guolic1/LumaFlow/shell/LumaFlowShell.FCStd

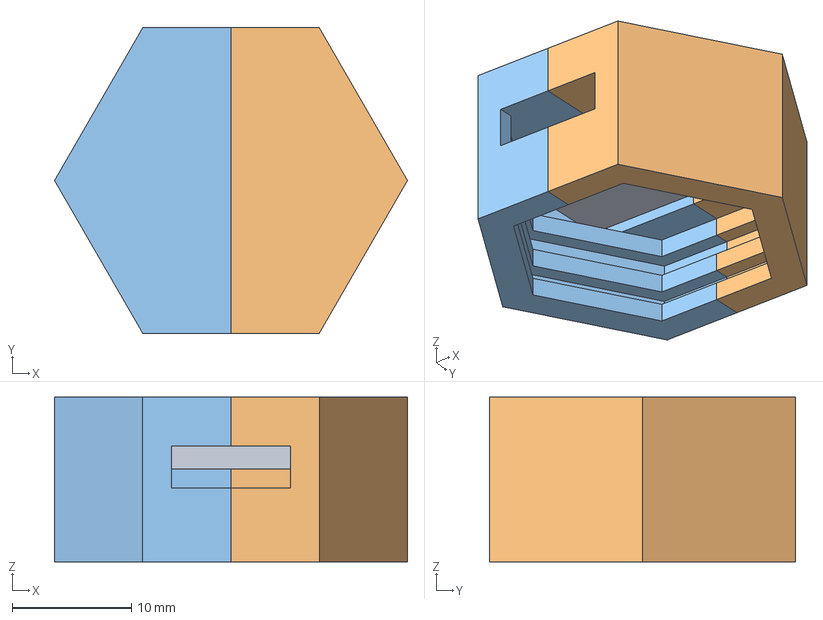
[picture p1: CAD file, 2026-10-01]
shell/LumaFlowShell.FCStd
29.6 x 25.6 x 13.8 mm
Battary
Left
