guolic1/LumaFlow/circuit/LumaFlow.kicad_pcb

## KiCad design circuit/LumaFlow.kicad_pcb (2026-09-30)

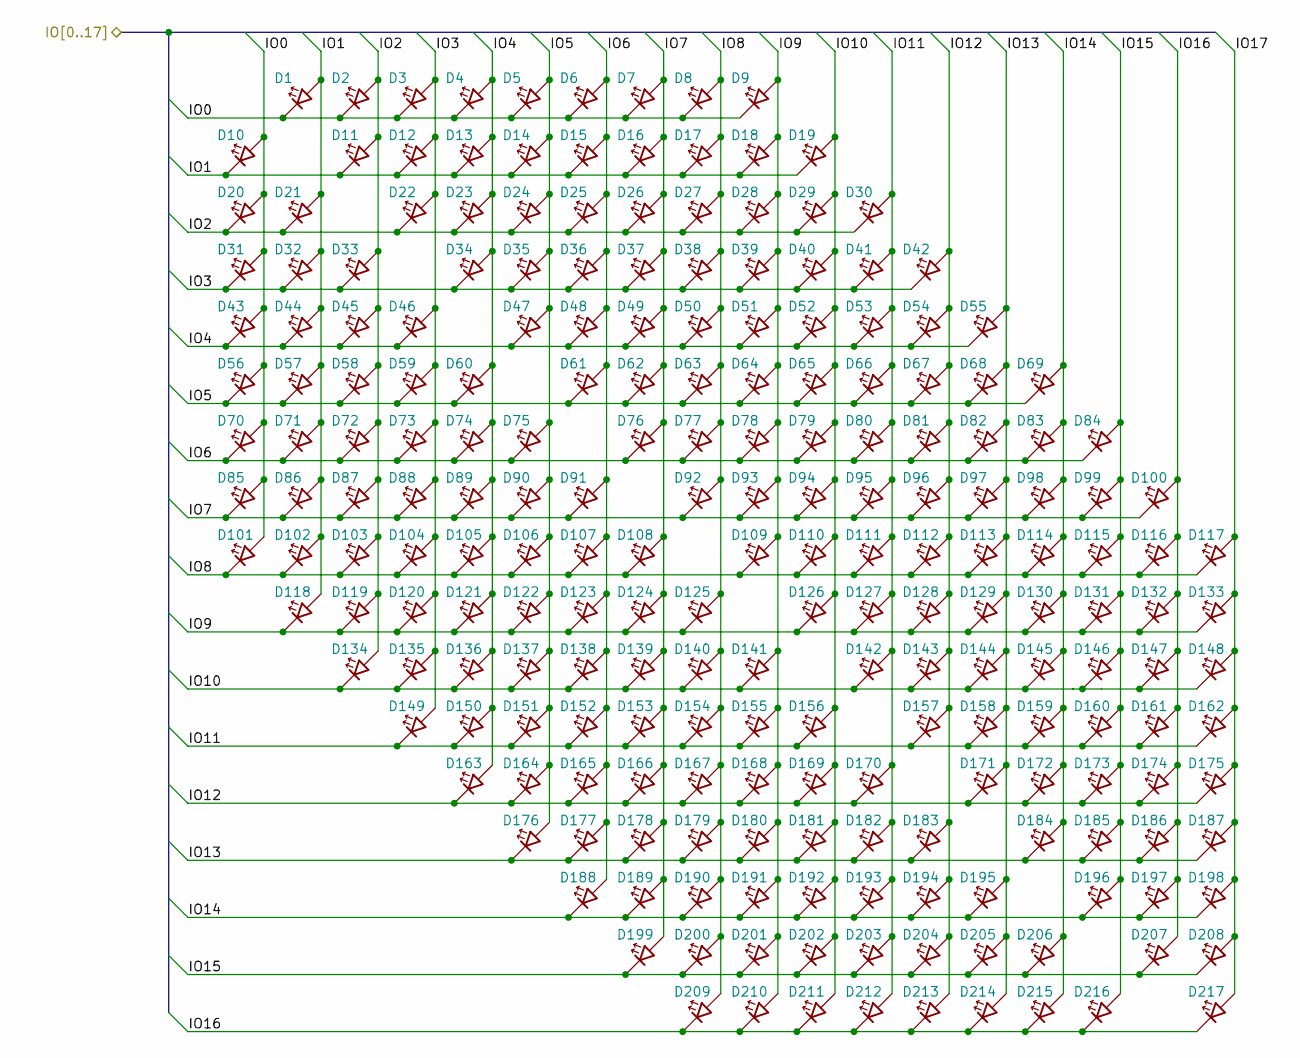
[picture p2: schematic LED_Matrix.kicad_sch]

Parts:
D1, D2, D3, D4, D5, D6, D7, D8, D9, D10, D11, D12, D13, D14, D15, D16, D17, D18, D19, D20, D21, D22, D23, D24, D25, D26, D27, D28, D29, D30, D31, D32, D33, D34, D35, D36, D37, D38, D39, D40, D41, D42, D43, D44, D45, D46, D47, D48, D49, D50, D51, D52, D53, D54, D55, D56, D57, D58, D59, D60, D61, D62, D63, D64, D65, D66, D67, D68, D69, D70, D71, D72, D73, D74, D75, D76, D77, D78, D79, D80, D81, D82, D83, D84, D85, D86, D87, D88, D89, D90, D91, D92, D93, D94, D95, D96, D97, D98, D99, D100, D101, D102, D103, D104, D105, D106, D107, D108, D109, D110, D111, D112, D113, D114, D115, D116, D117, D118, D119, D120, D121, D122, D123, D124, D125, D126, D127, D128, D129, D130, D131, D132, D133, D134, D135, D136, D137, D138, D139, D140, D141, D142, D143, D144, D145, D146, D147, D148, D149, D150, D151, D152, D153, D154, D155, D156, D157, D158, D159, D160, D161, D162, D163, D164, D165, D166, D167, D168, D169, D170, D171, D172, D173, D174, D175, D176, D177, D178, D179, D180, D181, D182, D183, D184, D185, D186, D187, D188, D189, D190, D191, D192, D193, D194, D195, D196, D197, D198, D199, D200, D201, D202, D203, D204, D205, D206, D207, D208, D209, D210, D211, D212, D213, D214, D215, D216, D217: LED; LED_0402_1005Metric

Connections:
/LED Matrix/IO0: D1.1 (K), D2.1 (K), D3.1 (K), D4.1 (K), D5.1 (K), D6.1 (K), D7.1 (K), D8.1 (K), D9.1 (K), D10.2 (A), D20.2 (A), D31.2 (A), D43.2 (A), D56.2 (A), D70.2 (A), D85.2 (A), D101.2 (A); also elsewhere on the board
/LED Matrix/IO1: D1.2 (A), D10.1 (K), D11.1 (K), D12.1 (K), D13.1 (K), D14.1 (K), D15.1 (K), D16.1 (K), D17.1 (K), D18.1 (K), D19.1 (K), D21.2 (A), D32.2 (A), D44.2 (A), D57.2 (A), D71.2 (A), D86.2 (A), D102.2 (A), D118.2 (A); also elsewhere on the board
/LED Matrix/IO2: D2.2 (A), D11.2 (A), D20.1 (K), D21.1 (K), D22.1 (K), D23.1 (K), D24.1 (K), D25.1 (K), D26.1 (K), D27.1 (K), D28.1 (K), D29.1 (K), D30.1 (K), D33.2 (A), D45.2 (A), D58.2 (A), D72.2 (A), D87.2 (A), D103.2 (A), D119.2 (A), D134.2 (A); also elsewhere on the board
/LED Matrix/IO3: D3.2 (A), D12.2 (A), D22.2 (A), D31.1 (K), D32.1 (K), D33.1 (K), D34.1 (K), D35.1 (K), D36.1 (K), D37.1 (K), D38.1 (K), D39.1 (K), D40.1 (K), D41.1 (K), D42.1 (K), D46.2 (A), D59.2 (A), D73.2 (A), D88.2 (A), D104.2 (A), D120.2 (A), D135.2 (A), D149.2 (A); also elsewhere on the board
/LED Matrix/IO4: D4.2 (A), D13.2 (A), D23.2 (A), D34.2 (A), D43.1 (K), D44.1 (K), D45.1 (K), D46.1 (K), D47.1 (K), D48.1 (K), D49.1 (K), D50.1 (K), D51.1 (K), D52.1 (K), D53.1 (K), D54.1 (K), D55.1 (K), D60.2 (A), D74.2 (A), D89.2 (A), D105.2 (A), D121.2 (A), D136.2 (A), D150.2 (A), D163.2 (A); also elsewhere on the board
/LED Matrix/IO5: D5.2 (A), D14.2 (A), D24.2 (A), D35.2 (A), D47.2 (A), D56.1 (K), D57.1 (K), D58.1 (K), D59.1 (K), D60.1 (K), D61.1 (K), D62.1 (K), D63.1 (K), D64.1 (K), D65.1 (K), D66.1 (K), D67.1 (K), D68.1 (K), D69.1 (K), D75.2 (A), D90.2 (A), D106.2 (A), D122.2 (A), D137.2 (A), D151.2 (A), D164.2 (A), D176.2 (A); also elsewhere on the board
/LED Matrix/IO6: D6.2 (A), D15.2 (A), D25.2 (A), D36.2 (A), D48.2 (A), D61.2 (A), D70.1 (K), D71.1 (K), D72.1 (K), D73.1 (K), D74.1 (K), D75.1 (K), D76.1 (K), D77.1 (K), D78.1 (K), D79.1 (K), D80.1 (K), D81.1 (K), D82.1 (K), D83.1 (K), D84.1 (K), D91.2 (A), D107.2 (A), D123.2 (A), D138.2 (A), D152.2 (A), D165.2 (A), D177.2 (A), D188.2 (A); also elsewhere on the board
/LED Matrix/IO7: D7.2 (A), D16.2 (A), D26.2 (A), D37.2 (A), D49.2 (A), D62.2 (A), D76.2 (A), D85.1 (K), D86.1 (K), D87.1 (K), D88.1 (K), D89.1 (K), D90.1 (K), D91.1 (K), D92.1 (K), D93.1 (K), D94.1 (K), D95.1 (K), D96.1 (K), D97.1 (K), D98.1 (K), D99.1 (K), D100.1 (K), D108.2 (A), D124.2 (A), D139.2 (A), D153.2 (A), D166.2 (A), D178.2 (A), D189.2 (A), D199.2 (A); also elsewhere on the board
/LED Matrix/IO8: D8.2 (A), D17.2 (A), D27.2 (A), D38.2 (A), D50.2 (A), D63.2 (A), D77.2 (A), D92.2 (A), D101.1 (K), D102.1 (K), D103.1 (K), D104.1 (K), D105.1 (K), D106.1 (K), D107.1 (K), D108.1 (K), D109.1 (K), D110.1 (K), D111.1 (K), D112.1 (K), D113.1 (K), D114.1 (K), D115.1 (K), D116.1 (K), D117.1 (K), D125.2 (A), D140.2 (A), D154.2 (A), D167.2 (A), D179.2 (A), D190.2 (A), D200.2 (A), D209.2 (A); also elsewhere on the board
/LED Matrix/IO9: D9.2 (A), D18.2 (A), D28.2 (A), D39.2 (A), D51.2 (A), D64.2 (A), D78.2 (A), D93.2 (A), D109.2 (A), D118.1 (K), D119.1 (K), D120.1 (K), D121.1 (K), D122.1 (K), D123.1 (K), D124.1 (K), D125.1 (K), D126.1 (K), D127.1 (K), D128.1 (K), D129.1 (K), D130.1 (K), D131.1 (K), D132.1 (K), D133.1 (K), D141.2 (A), D155.2 (A), D168.2 (A), D180.2 (A), D191.2 (A), D201.2 (A), D210.2 (A); also elsewhere on the board
/LED Matrix/IO10: D19.2 (A), D29.2 (A), D40.2 (A), D52.2 (A), D65.2 (A), D79.2 (A), D94.2 (A), D110.2 (A), D126.2 (A), D134.1 (K), D135.1 (K), D136.1 (K), D137.1 (K), D138.1 (K), D139.1 (K), D140.1 (K), D141.1 (K), D142.1 (K), D143.1 (K), D144.1 (K), D145.1 (K), D146.1 (K), D147.1 (K), D148.1 (K), D156.2 (A), D169.2 (A), D181.2 (A), D192.2 (A), D202.2 (A), D211.2 (A); also elsewhere on the board
/LED Matrix/IO11: D30.2 (A), D41.2 (A), D53.2 (A), D66.2 (A), D80.2 (A), D95.2 (A), D111.2 (A), D127.2 (A), D142.2 (A), D149.1 (K), D150.1 (K), D151.1 (K), D152.1 (K), D153.1 (K), D154.1 (K), D155.1 (K), D156.1 (K), D157.1 (K), D158.1 (K), D159.1 (K), D160.1 (K), D161.1 (K), D162.1 (K), D170.2 (A), D182.2 (A), D193.2 (A), D203.2 (A), D212.2 (A); also elsewhere on the board
/LED Matrix/IO12: D42.2 (A), D54.2 (A), D67.2 (A), D81.2 (A), D96.2 (A), D112.2 (A), D128.2 (A), D143.2 (A), D157.2 (A), D163.1 (K), D164.1 (K), D165.1 (K), D166.1 (K), D167.1 (K), D168.1 (K), D169.1 (K), D170.1 (K), D171.1 (K), D172.1 (K), D173.1 (K), D174.1 (K), D175.1 (K), D183.2 (A), D194.2 (A), D204.2 (A), D213.2 (A); also elsewhere on the board
/LED Matrix/IO13: D55.2 (A), D68.2 (A), D82.2 (A), D97.2 (A), D113.2 (A), D129.2 (A), D144.2 (A), D158.2 (A), D171.2 (A), D176.1 (K), D177.1 (K), D178.1 (K), D179.1 (K), D180.1 (K), D181.1 (K), D182.1 (K), D183.1 (K), D184.1 (K), D185.1 (K), D186.1 (K), D187.1 (K), D195.2 (A), D205.2 (A), D214.2 (A); also elsewhere on the board
/LED Matrix/IO14: D69.2 (A), D83.2 (A), D98.2 (A), D114.2 (A), D130.2 (A), D145.2 (A), D159.2 (A), D172.2 (A), D184.2 (A), D188.1 (K), D189.1 (K), D190.1 (K), D191.1 (K), D192.1 (K), D193.1 (K), D194.1 (K), D195.1 (K), D196.1 (K), D197.1 (K), D198.1 (K), D206.2 (A), D215.2 (A); also elsewhere on the board
/LED Matrix/IO15: D84.2 (A), D99.2 (A), D115.2 (A), D131.2 (A), D146.2 (A), D160.2 (A), D173.2 (A), D185.2 (A), D196.2 (A), D199.1 (K), D200.1 (K), D201.1 (K), D202.1 (K), D203.1 (K), D204.1 (K), D205.1 (K), D206.1 (K), D207.1 (K), D208.1 (K), D216.2 (A); also elsewhere on the board
/LED Matrix/IO16: D100.2 (A), D116.2 (A), D132.2 (A), D147.2 (A), D161.2 (A), D174.2 (A), D186.2 (A), D197.2 (A), D207.2 (A), D209.1 (K), D210.1 (K), D211.1 (K), D212.1 (K), D213.1 (K), D214.1 (K), D215.1 (K), D216.1 (K), D217.1 (K); also elsewhere on the board
/LED Matrix/IO17: D117.2 (A), D133.2 (A), D148.2 (A), D162.2 (A), D175.2 (A), D187.2 (A), D198.2 (A), D208.2 (A), D217.2 (A); also elsewhere on the board

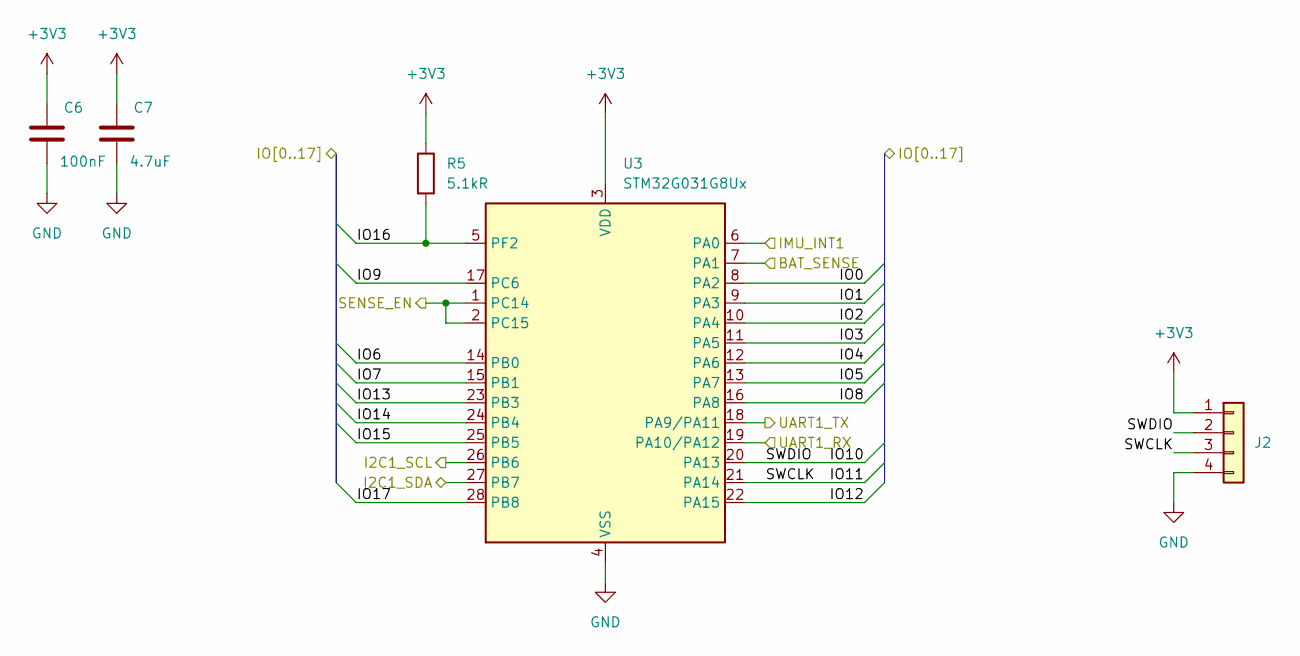
[picture p3: schematic MCU.kicad_sch]

Parts:
C6: 100nF; C_0402_1005Metric
C7: 4.7uF; C_0402_1005Metric
J2: Conn_01x04; PinSocket_1x04_P1.27mm_Vertical
R5: 5.1kR; R_0402_1005Metric
U3: STM32G031G8Ux; QFN-28_4x4mm_P0.5mm

Connections:
+3V3: C6.1, C7.1, J2.1, R5.1, U3.3 (VDD); also elsewhere on the board
/IMU/INT1: U3.6 (PA0); also elsewhere on the board
/IMU/SCL: U3.26 (PB6); also elsewhere on the board
/IMU/SDA: U3.27 (PB7); also elsewhere on the board
/LED Matrix/IO0: U3.8 (PA2); also elsewhere on the board
/LED Matrix/IO1: U3.9 (PA3); also elsewhere on the board
/LED Matrix/IO2: U3.10 (PA4); also elsewhere on the board
/LED Matrix/IO3: U3.11 (PA5); also elsewhere on the board
/LED Matrix/IO4: U3.12 (PA6); also elsewhere on the board
/LED Matrix/IO5: U3.13 (PA7); also elsewhere on the board
/LED Matrix/IO6: U3.14 (PB0); also elsewhere on the board
/LED Matrix/IO7: U3.15 (PB1); also elsewhere on the board
/LED Matrix/IO8: U3.16 (PA8); also elsewhere on the board
/LED Matrix/IO9: U3.17 (PC6); also elsewhere on the board
/LED Matrix/IO10: J2.2, U3.20 (PA13); also elsewhere on the board
/LED Matrix/IO11: J2.3, U3.21 (PA14); also elsewhere on the board
/LED Matrix/IO12: U3.22 (PA15); also elsewhere on the board
/LED Matrix/IO13: U3.23 (PB3); also elsewhere on the board
/LED Matrix/IO14: U3.24 (PB4); also elsewhere on the board
/LED Matrix/IO15: U3.25 (PB5); also elsewhere on the board
/LED Matrix/IO16: R5.2, U3.5 (PF2); also elsewhere on the board
/LED Matrix/IO17: U3.28 (PB8); also elsewhere on the board
/MCU/BAT_SENSE: U3.7 (PA1); also elsewhere on the board
/MCU/SENSE_EN: U3.1 (PC14), U3.2 (PC15); also elsewhere on the board
/MCU/UART1_RX: U3.19 (PA10/PA12); also elsewhere on the board
/MCU/UART1_TX: U3.18 (PA9/PA11); also elsewhere on the board
GND: C6.2, C7.2, J2.4, U3.4 (VSS); also elsewhere on the board

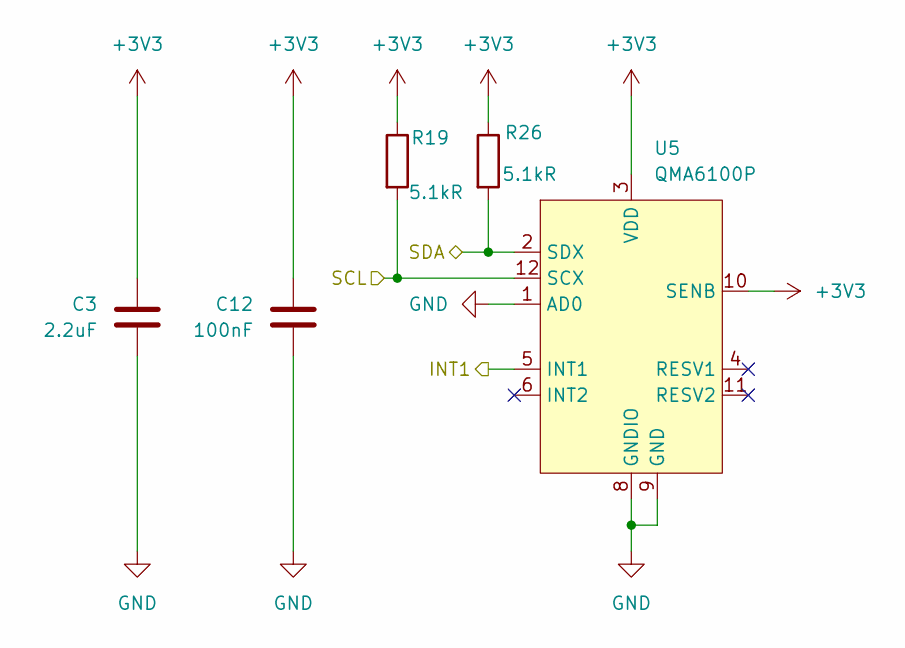
[picture p4: schematic IMU.kicad_sch]

Parts:
C3: 2.2uF; C_0402_1005Metric
C12: 100nF; C_0402_1005Metric
R19, R26: 5.1kR; R_0402_1005Metric
U5: QMA6100P; LGA-12_2x2mm_P0.5mm

Connections:
+3V3: C3.1, C12.1, R19.1, R26.1, U5.3 (VDD), U5.10 (SENB); also elsewhere on the board
/IMU/INT1: U5.5 (INT1); also elsewhere on the board
/IMU/SCL: R19.2, U5.12 (SCX); also elsewhere on the board
/IMU/SDA: R26.2, U5.2 (SDX); also elsewhere on the board
GND: C3.2, C12.2, U5.1 (AD0), U5.8 (GNDIO), U5.9 (GND); also elsewhere on the board

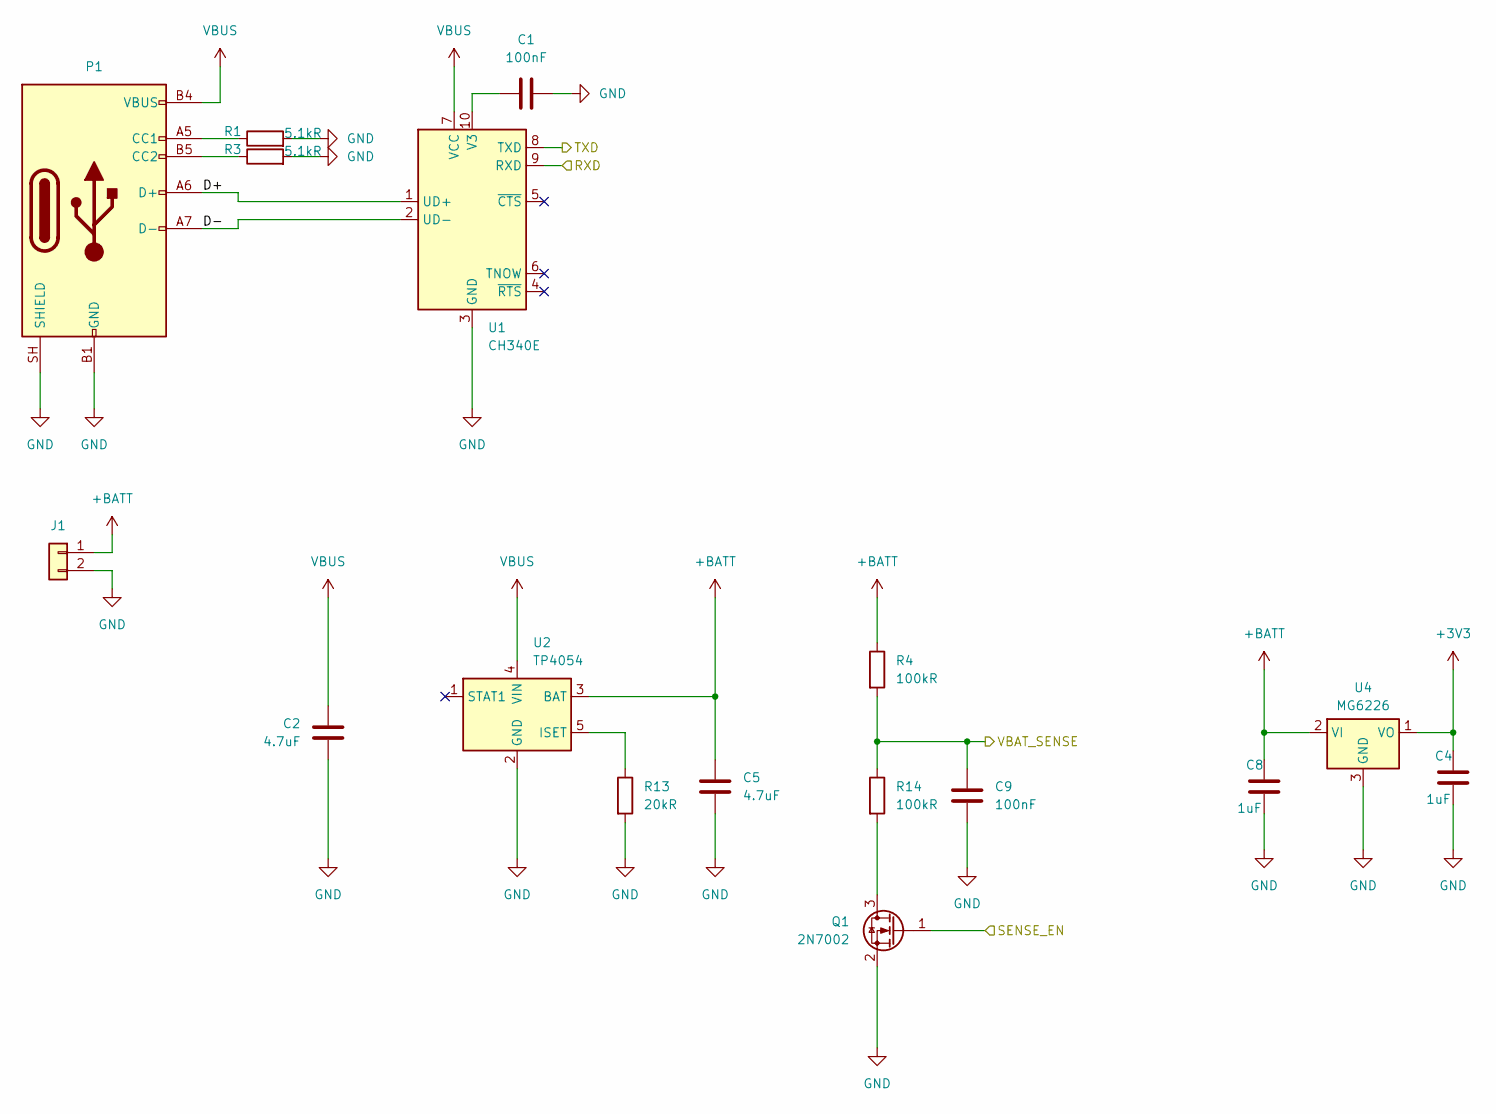
[picture p5: schematic Power.kicad_sch]

Parts:
C1, C9: 100nF; C_0402_1005Metric
C2, C5: 4.7uF; C_0402_1005Metric
C4, C8: 1uF; C_0402_1005Metric
J1: Conn_01x02
P1: USB_C_Plug_USB2.0_8Pin; USB-C-SMD_MC-402L68
Q1: 2N7002; SOT-323_SC-70
R1, R3: 5.1kR; R_0402_1005Metric
R4, R14: 100kR; R_0402_1005Metric
R13: 20kR; R_0402_1005Metric
U1: CH340E; MSOP-10_3x3mm_P0.5mm
U2: TP4054; SOT-23-5
U4: MG6226; SOT-23-3

Connections:
+3V3: C4.1, U4.1 (VO); also elsewhere on the board
+BATT: C5.1, C8.1, J1.1, R4.1, U2.3 (BAT), U4.2 (VI)
/MCU/BAT_SENSE: C9.1, R4.2, R14.1; also elsewhere on the board
/MCU/SENSE_EN: Q1.1 (G); also elsewhere on the board
/MCU/UART1_RX: U1.8 (TXD); also elsewhere on the board
/MCU/UART1_TX: U1.9 (RXD); also elsewhere on the board
/Power/D+: P1.A6 (D+), U1.1 (UD+)
/Power/D-: P1.A7 (D-), U1.2 (UD-)
GND: C1.2, C2.2, C4.2, C5.2, C8.2, C9.2, J1.2, P1.B1 (GND), P1.B12 (GND), P1.SH (SHIELD), Q1.2 (S), R1.2, R3.2, R13.2, U1.3 (GND), U2.2 (GND), U4.3 (GND); also elsewhere on the board
unnamed: P1.A5 (CC1), R1.1
unnamed: P1.B5 (CC2), R3.1
unnamed: Q1.3 (D), R14.2
unnamed: C1.1, U1.10 (V3)
unnamed: R13.1, U2.5 (ISET)
VBUS: C2.1, P1.B4 (VBUS), P1.B9 (VBUS), U1.7 (VCC), U2.4 (VIN)

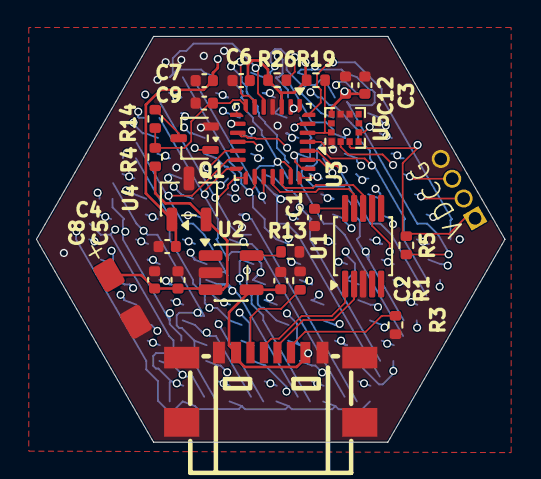
[picture p6: board LumaFlow.kicad_pcb from above]

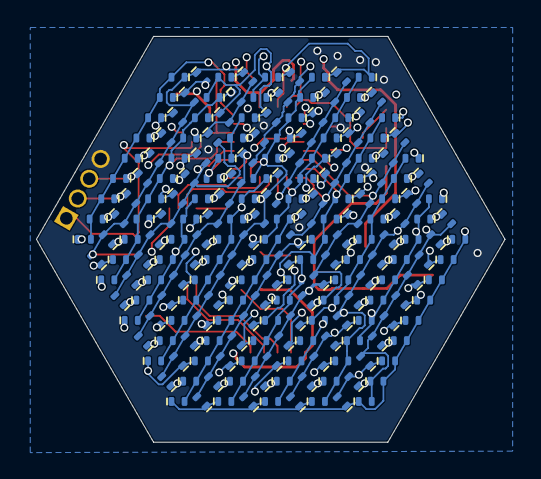
[picture p7: board LumaFlow.kicad_pcb from below]

Board: 4 copper layers, 26.0 x 22.5 mm, 244 parts (217 on the bottom side), 36 nets.
