guolic1/LumaFlow/firmware/board/LumaFlow.ioc

Mcu.UserName=STM32G031G8Ux
PA0.GPIO_Label=IMU_INT
PA0.Signal=GPXTI0
PA1.GPIO_Label=BAT_SENSE
PA1.Signal=ADC1_IN1
PA13.GPIO_Label=IO10
PA13.Signal=SYS_SWDIO
PA14-BOOT0.GPIO_Label=IO11
PA14-BOOT0.Signal=SYS_SWCLK
PA15.GPIO_Label=IO12
PA15.Signal=GPIO_Output
PA2.GPIO_Label=IO0
PA2.Signal=GPIO_Output
PA3.GPIO_Label=IO1
PA3.Signal=GPIO_Output
PA4.GPIO_Label=IO2
PA4.Signal=GPIO_Output
PA5.GPIO_Label=IO3
PA5.Signal=GPIO_Output
PA6.GPIO_Label=IO4
PA6.Signal=GPIO_Output
PA7.GPIO_Label=IO5
PA7.Signal=GPIO_Output
PA8.GPIO_Label=IO8
PA8.Signal=GPIO_Output
PB0.GPIO_Label=IO6
PB0.Signal=GPIO_Output
PB1.GPIO_Label=IO7
PB1.Signal=GPIO_Output
PB3.GPIO_Label=IO13
PB3.Signal=GPIO_Output
PB4.GPIO_Label=IO14
PB4.Signal=GPIO_Output
PB5.GPIO_Label=IO15
PB5.Signal=GPIO_Output
PB6.Signal=I2C1_SCL
PB7.Signal=I2C1_SDA
PB8.GPIO_Label=IO17
PB8.Signal=GPIO_Output
PC6.GPIO_Label=IO9
PC6.Signal=GPIO_Output
