guolic1/LumaFlow/firmware/board/Core/Inc/main.h

#define SENSE_EN_Pin LL_GPIO_PIN_14
#define SENSE_EN_GPIO_Port GPIOC
#define IO16_Pin LL_GPIO_PIN_2
#define IO16_GPIO_Port GPIOF
#define IMU_INT_Pin LL_GPIO_PIN_0
#define IMU_INT_GPIO_Port GPIOA
#define BAT_SENSE_Pin LL_GPIO_PIN_1
#define BAT_SENSE_GPIO_Port GPIOA
#define IO0_Pin LL_GPIO_PIN_2
#define IO0_GPIO_Port GPIOA
#define IO1_Pin LL_GPIO_PIN_3
#define IO1_GPIO_Port GPIOA
#define IO2_Pin LL_GPIO_PIN_4
#define IO2_GPIO_Port GPIOA
#define IO3_Pin LL_GPIO_PIN_5
#define IO3_GPIO_Port GPIOA
#define IO4_Pin LL_GPIO_PIN_6
#define IO4_GPIO_Port GPIOA
#define IO5_Pin LL_GPIO_PIN_7
#define IO5_GPIO_Port GPIOA
#define IO6_Pin LL_GPIO_PIN_0
#define IO6_GPIO_Port GPIOB
#define IO7_Pin LL_GPIO_PIN_1
#define IO7_GPIO_Port GPIOB
#define IO8_Pin LL_GPIO_PIN_8
#define IO8_GPIO_Port GPIOA
#define IO9_Pin LL_GPIO_PIN_6
#define IO9_GPIO_Port GPIOC
#define IO10_Pin LL_GPIO_PIN_13
#define IO10_GPIO_Port GPIOA
#define IO11_Pin LL_GPIO_PIN_14
#define IO11_GPIO_Port GPIOA
#define IO12_Pin LL_GPIO_PIN_15
#define IO12_GPIO_Port GPIOA
#define IO13_Pin LL_GPIO_PIN_3
#define IO13_GPIO_Port GPIOB
#define IO14_Pin LL_GPIO_PIN_4
#define IO14_GPIO_Port GPIOB
#define IO15_Pin LL_GPIO_PIN_5
#define IO15_GPIO_Port GPIOB
#define IO17_Pin LL_GPIO_PIN_8
#define IO17_GPIO_Port GPIOB
