guolic1/LumaFlow/firmware/application/qma6100p.h

#ifndef QMA6100P_H
#define QMA6100P_H

#include <stdbool.h>
#include <stdint.h>

#define QMA6100P_RANGE_G 8U
#define QMA6100P_COUNTS_PER_G (8192U / QMA6100P_RANGE_G)

typedef enum
{
    QMA6100P_OK = 0,
    QMA6100P_BUS_ERROR = 1,
    QMA6100P_CHIP_ID_ERROR = 2,
    QMA6100P_CONFIG_ERROR = 3,
} qma6100p_status_t;

typedef struct
{
    bool (*read)(uint8_t reg, uint8_t *data, uint8_t length);
    bool (*write)(uint8_t reg, uint8_t value);
    void (*delay_ms)(uint32_t duration);
} qma6100p_bus_t;

typedef struct
{
    qma6100p_bus_t bus;
    bool ready;
} qma6100p_t;

typedef struct
{
    int16_t x;
    int16_t y;
    int16_t z;
    uint8_t new_data;
} qma6100p_sample_t;

/* Fixed configuration: address is selected by the bus, +/-8g, nominal 100Hz.
 * Samples retain native signed 14-bit counts (1024 LSB/g), not normalized units. */
qma6100p_status_t qma6100p_init(qma6100p_t *device, qma6100p_bus_t bus);
qma6100p_status_t qma6100p_read(qma6100p_t *device, qma6100p_sample_t *sample);
/* Latched INT1, active high, XYZ adjacent-sample motion. Sleep rates: 25/50/100Hz.
 * Keep BW[4:0]=0 and scale MCLK for sleep; disabling restores MCLK=51.2kHz
 * and normal 100Hz sampling. Threshold/rate are then ignored.
 * Both transitions wait for two fresh XYZ samples, with a bounded 1s timeout. */
qma6100p_status_t qma6100p_set_motion_wake(qma6100p_t *device, bool enabled, uint16_t threshold_mg,
                                           uint16_t sample_rate_hz);
qma6100p_status_t qma6100p_read_motion(qma6100p_t *device, bool *motion);
/* Read-to-clear: preserve the raw trigger axes/sign before clearing the latch. */
qma6100p_status_t qma6100p_read_motion_status(qma6100p_t *device, uint8_t *status);

#endif
