guolic1/LumaFlow/firmware/common/protocol/common_commands.h

#ifndef COMMON_COMMANDS_H
#define COMMON_COMMANDS_H

#include "command_protocol.h"

#define COMMAND_ID_PING 0x01U
#define COMMAND_ID_GET_INFO 0x02U
#define COMMAND_ID_ENTER_BOOTLOADER 0x10U
#define COMMAND_ID_BOOT_APPLICATION 0x11U
#define COMMAND_ID_BEGIN_UPDATE 0x20U
#define COMMAND_ID_WRITE_CHUNK 0x21U
#define COMMAND_ID_END_UPDATE 0x22U
#define COMMAND_ID_GET_UPDATE_STATUS 0x23U
#define COMMAND_ID_GET_IMU 0x30U
#define COMMAND_ID_GET_FLUID 0x31U
#define COMMAND_ID_GET_WAKE 0x32U

#define COMMAND_IMAGE_BOOTLOADER 1U
#define COMMAND_IMAGE_APPLICATION 2U

#define COMMAND_CAPABILITY_ENTER_BOOTLOADER (1UL << 0U)
#define COMMAND_CAPABILITY_BOOT_APPLICATION (1UL << 1U)
#define COMMAND_CAPABILITY_UPDATE_APPLICATION (1UL << 2U)
#define COMMAND_CAPABILITY_READ_IMU (1UL << 3U)
#define COMMAND_CAPABILITY_READ_FLUID (1UL << 4U)
#define COMMAND_CAPABILITY_READ_WAKE (1UL << 5U)

typedef struct
{
    uint8_t image_type;
    uint8_t version_major;
    uint8_t version_minor;
    uint8_t version_patch;
    uint32_t capabilities;
} command_device_info_t;

command_status_t command_handle_ping(const void *context, const uint8_t *request,
                                     uint16_t request_length, uint8_t *response,
                                     uint16_t response_capacity, uint16_t *response_length);

command_status_t command_handle_get_info(const void *context, const uint8_t *request,
                                         uint16_t request_length, uint8_t *response,
                                         uint16_t response_capacity, uint16_t *response_length);

#endif
