guolic1/LumaFlow/firmware/tests/fluid_sim_test.c

#include <assert.h>
#include <stdio.h>
#include <stdlib.h>
#include <string.h>

#include "fluid_sim.h"
#include "fluid_sim_tables.h"

static fluid_sim_t sim;

static void test_surface_tension(void)
{
    const int offsets[][2] = {{1000, 0},   {800, 400},   {-800, 400},
                              {800, -400}, {-800, -400}, {FLUID_SURFACE_TENSION_RADIUS + 100, 0},
                              {100, 0}};
    for (unsigned k = 0U; k < sizeof(offsets) / sizeof(offsets[0]); ++k)
    {
        fluid_sim_init(&sim);
        for (unsigned i = 2U; i < FLUID_PARTICLE_COUNT; ++i)
        {
            sim.particles[i] = (fluid_particle_t){FLUID_CENTER, 10500, 0, 0};
        }
        int dx = offsets[k][0], dy = offsets[k][1];
        sim.particles[0] = (fluid_particle_t){FLUID_CENTER - dx / 2, FLUID_CENTER - dy / 2, 0, 0};
        sim.particles[1] = (fluid_particle_t){FLUID_CENTER + dx / 2, FLUID_CENTER + dy / 2, 0, 0};
        assert(fluid_sim_begin(&sim, 0, 0));
        assert(!fluid_sim_advance(&sim));
        while (sim.phase == FLUID_PHASE_SEPARATE)
        {
            assert(!fluid_sim_advance(&sim));
        }
        const fluid_particle_t *a = &sim.particles[0], *b = &sim.particles[1];
        assert(a->vx == -b->vx && a->vy == -b->vy);
        if (k < 5U)
        {
            /* Attraction points toward the neighbor and conserves pair momentum. */
            assert(a->vx * dx > 0);
            assert(dy == 0 ? a->vy == 0 : a->vy * dy > 0);
        }
        else
        {
            /* No long-range attraction or attractive force on an overlapping pair. */
            assert(a->vx == 0 && a->vy == 0);
        }
        if (k == 6U)
        {
            assert(b->x - a->x >= FLUID_PARTICLE_DISTANCE - 1);
        }
    }
    /* A resting close pair must visibly approach over complete simulation steps. */
    fluid_sim_init(&sim);
    sim.particles[0] = (fluid_particle_t){FLUID_CENTER - 500, 3584, 0, 0};
    sim.particles[1] = (fluid_particle_t){FLUID_CENTER + 500, 3584, 0, 0};
    for (unsigned frame = 0U; frame < 3U; ++frame)
    {
        assert(fluid_sim_begin(&sim, 0, 0));
        while (!fluid_sim_advance(&sim))
        {
        }
    }
    assert(sim.particles[1].x - sim.particles[0].x < 1000);
}

static void test_wall_rebound(void)
{
    fluid_sim_init(&sim);
    sim.particles[0] = (fluid_particle_t){FLUID_CENTER, FLUID_CENTER + FLUID_WALL - 100, 100, 400};
    assert(fluid_sim_begin(&sim, 0, 0));
    assert(!fluid_sim_advance(&sim));
    assert(sim.particles[0].vx == 98 && sim.particles[0].vy == -49);
    assert(fluid_sim_contains(sim.particles[0].x, sim.particles[0].y));
    /* Moving away from a wall must not trigger another bounce. */
    sim.phase = FLUID_PHASE_IDLE;
    sim.particles[0] = (fluid_particle_t){FLUID_CENTER, FLUID_CENTER + FLUID_WALL - 1, 0, -400};
    assert(fluid_sim_begin(&sim, 0, 0));
    assert(!fluid_sim_advance(&sim));
    assert(sim.particles[0].vy == -393);
    /* The swept high-speed path uses the same restitution as ordinary motion. */
    sim.phase = FLUID_PHASE_IDLE;
    sim.particles[0] = (fluid_particle_t){FLUID_CENTER, FLUID_CENTER, 0, 16384};
    assert(fluid_sim_begin(&sim, 0, 0));
    assert(!fluid_sim_advance(&sim));
    assert(sim.particles[0].vy == -2016);
    assert(fluid_sim_contains(sim.particles[0].x, sim.particles[0].y));
    /* Sloped walls reflect the normal component while retaining tangential motion. */
    sim.phase = FLUID_PHASE_IDLE;
    sim.particles[0] = (fluid_particle_t){FLUID_CENTER + 3500, FLUID_CENTER + 2000, 400, 200};
    assert(fluid_sim_begin(&sim, 0, 0));
    assert(!fluid_sim_advance(&sim));
    const fluid_particle_t *p = &sim.particles[0];
    assert(p->vx * 887 + p->vy * 512 < 0);
    assert(abs((-512 * p->vx + 887 * p->vy) - (-512 * 393 + 887 * 196)) <= 2048);
    assert(p->vx * p->vx + p->vy * p->vy <= 393 * 393 + 196 * 196);
    assert(fluid_sim_contains(p->x, p->y));
}

static void test_velocity_damping(void)
{
    fluid_sim_init(&sim);
    sim.particles[0] = (fluid_particle_t){FLUID_CENTER, FLUID_CENTER, 1024, -512};
    assert(fluid_sim_begin(&sim, 0, 0));
    assert(!fluid_sim_advance(&sim));
    assert(sim.particles[0].vx == 1008 && sim.particles[0].vy == -504);
    assert(sim.particles[0].x == FLUID_CENTER + 2016);
    assert(sim.particles[0].y == FLUID_CENTER - 1008);
    /* Once per physical step, not once per cooperative slice or separation pass. */
    int16_t vx = sim.particles[0].vx, vy = sim.particles[0].vy;
    assert(!fluid_sim_advance(&sim));
    assert(sim.particles[0].vx == vx && sim.particles[0].vy == vy);
}

static void test_high_speed_motion(void)
{
    fluid_sim_init(&sim);
    sim.particles[0] = (fluid_particle_t){FLUID_CENTER, FLUID_CENTER, 2000, 0};
    assert(fluid_sim_begin(&sim, 0, 0));
    assert(!fluid_sim_advance(&sim));
    assert(sim.particles[0].vx == 1968 && sim.particles[0].x == FLUID_CENTER + 3936);
    /* Exercise all travel directions from interior and near-wall positions. */
    for (int y = 2200; y <= 11100; y += 445)
    {
        for (int x = 1500; x <= 11800; x += 515)
        {
            if (!fluid_sim_contains((int16_t)x, (int16_t)y))
            {
                continue;
            }
            for (int vx = -16384; vx <= 16384; vx += 4096)
            {
                fluid_sim_init(&sim);
                for (unsigned i = 0U; i < FLUID_PARTICLE_COUNT; ++i)
                {
                    int vy = -16384 + (int)(i % 9U) * 4096;
                    sim.particles[i] =
                        (fluid_particle_t){(int16_t)x, (int16_t)y, (int16_t)vx, (int16_t)vy};
                }
                assert(fluid_sim_begin(&sim, 0, 0));
                assert(!fluid_sim_advance(&sim));
                for (unsigned i = 0U; i < FLUID_PARTICLE_COUNT; ++i)
                {
                    assert(fluid_sim_contains(sim.particles[i].x, sim.particles[i].y));
                    static const int normals[6][2] = {
                        {0, 1024}, {0, -1024}, {887, 512}, {887, -512}, {-887, 512}, {-887, -512},
                    };
                    const fluid_particle_t *p = &sim.particles[i];
                    for (unsigned wall = 0U; wall < 6U; ++wall)
                    {
                        int nx = normals[wall][0], ny = normals[wall][1];
                        int distance =
                            4559 - ((p->x - FLUID_CENTER) * nx + (p->y - FLUID_CENTER) * ny) / 1024;
                        if (distance <= 2)
                        {
                            /* Quantized contact must remove outward velocity, avoiding stalls. */
                            assert((p->vx * nx + p->vy * ny) / 1024 <= 3);
                        }
                    }
                }
            }
        }
    }
    /* A large positive displacement must hit the right wall, never wrap to the left. */
    fluid_sim_init(&sim);
    sim.particles[0] = (fluid_particle_t){FLUID_CENTER, FLUID_CENTER, 16384, 0};
    assert(fluid_sim_begin(&sim, 0, 0));
    assert(!fluid_sim_advance(&sim));
    assert(sim.particles[0].x > FLUID_CENTER + 4000);
    assert(fluid_sim_contains(sim.particles[0].x, sim.particles[0].y));
    /* Out-of-range initial velocities are clamped, with or without an extra impulse. */
    fluid_sim_init(&sim);
    sim.particles[0] = (fluid_particle_t){FLUID_CENTER, FLUID_CENTER, INT16_MAX, 0};
    assert(fluid_sim_begin(&sim, -8192, 0));
    assert(!fluid_sim_advance(&sim));
    fluid_particle_t accelerated = sim.particles[0];
    fluid_sim_init(&sim);
    sim.particles[0] = (fluid_particle_t){FLUID_CENTER, FLUID_CENTER, INT16_MAX, 0};
    assert(fluid_sim_begin(&sim, 0, 0));
    assert(!fluid_sim_advance(&sim));
    assert(memcmp(&accelerated, &sim.particles[0], sizeof(accelerated)) == 0);
}

static void test_high_speed_transfer(void)
{
    for (int sign = -1; sign <= 1; sign += 2)
    {
        fluid_sim_init(&sim);
        for (unsigned i = 0U; i < FLUID_PARTICLE_COUNT; ++i)
        {
            sim.particles[i] = (fluid_particle_t){FLUID_CENTER, FLUID_CENTER,
                                                  (int16_t)(sign * 16384), (int16_t)(sign * 16384)};
        }
        memset(sim.scratch.cells.type, FLUID_CELL_LIQUID, sizeof(sim.scratch.cells.type));
        for (unsigned i = 0U; i < 2U * FLUID_FACE_COUNT; ++i)
        {
            sim.grid.velocity.current[i] = (int16_t)(sign * 16384);
            sim.grid.velocity.previous[i] = (int16_t)(-sign * 16384);
        }
        sim.phase = FLUID_PHASE_TRANSFER;
        while (!fluid_sim_advance(&sim))
        {
        }
        /* Maximum grid deltas must retain their sign and clamp after FLIP blending. */
        for (unsigned i = 0U; i < FLUID_PARTICLE_COUNT; ++i)
        {
            assert(sim.particles[i].vx == sign * 16384);
            assert(sim.particles[i].vy == sign * 16384);
        }
    }
}

static void test_step_duration(void)
{
    fluid_sim_init(&sim);
    sim.particles[0] = (fluid_particle_t){FLUID_CENTER, FLUID_CENTER, 90, -60};
    assert(fluid_sim_begin(&sim, 0, 0));
    assert(!fluid_sim_advance(&sim));
    /* Velocities retain their 20ms reference unit; a 25Hz step spans two units. */
    assert(sim.particles[0].x == FLUID_CENTER + 176);
    assert(sim.particles[0].y == FLUID_CENTER - 118);

    fluid_sim_init(&sim);
    sim.particles[0] = (fluid_particle_t){FLUID_CENTER, FLUID_CENTER, 0, 0};
    assert(fluid_sim_begin(&sim, -4096, 4096));
    assert(!fluid_sim_advance(&sim));
    assert(sim.particles[0].vx == 256 && sim.particles[0].vy == -256);
    assert(sim.particles[0].x == FLUID_CENTER + 512);
    assert(sim.particles[0].y == FLUID_CENTER - 512);

    fluid_sim_init(&sim);
    sim.particles[0] = (fluid_particle_t){FLUID_CENTER, FLUID_CENTER, 0, 0};
    assert(fluid_sim_begin(&sim, -8192, 8191));
    assert(!fluid_sim_advance(&sim));
    assert(sim.particles[0].vx == 512 && sim.particles[0].vy == -510);
    assert(sim.particles[0].x == FLUID_CENTER + 1024);
    assert(sim.particles[0].y == FLUID_CENTER - 1020);

    fluid_sim_init(&sim);
    sim.particles[0] = (fluid_particle_t){FLUID_CENTER, FLUID_CENTER, 768, -768};
    assert(fluid_sim_begin(&sim, 0, 0));
    assert(!fluid_sim_advance(&sim));
    assert(sim.particles[0].vx == 756 && sim.particles[0].vy == -756);
    assert(sim.particles[0].x == FLUID_CENTER + 1512);
    assert(sim.particles[0].y == FLUID_CENTER - 1512);
}

static bool open_cell(int x, int y)
{
    return x > 0 && x < 12 && y > 0 && y < 12 && abs((y - 6) * 1024) <= 5602 &&
           887 * abs((x - 6) * 1024) + 512 * abs((y - 6) * 1024) <= 5602 * 1024;
}

static void test_numeric_tables(void)
{
    for (unsigned axis = 0U; axis < 2U; ++axis)
    {
        for (int y = 0; y < 14; ++y)
        {
            for (int x = 0; x < 14; ++x)
            {
                int ax = x - (axis == 0U), ay = y - (axis == 1U);
                const uint8_t *cells = face_cells[axis * FLUID_FACE_COUNT + y * 14 + x];
                bool open = open_cell(ax, ay) && open_cell(x, y);
                assert(cells[0] == (open ? ay * 13 + ax : 0));
                assert(cells[1] == (open ? y * 13 + x : 0));
            }
        }
    }
    /* Quotient boundaries, large remainders and both signs across the caller range. */
    for (unsigned d = 1U; d <= 704U; ++d)
    {
        for (int32_t q = 0; q <= 1024; ++q)
        {
            int32_t values[] = {q * (int32_t)d, q * (int32_t)d - 1,
                                q * (int32_t)d + (int32_t)d - 1};
            for (unsigned k = 0U; k < 3U; ++k)
            {
                int32_t value = values[k];
                assert(divide_small(value, d) == value / (int32_t)d);
                assert(divide_small(-value, d) == -value / (int32_t)d);
            }
        }
    }
    /* Faster particle velocities also widen FLIP's delta quotient to +/-1536.
     * Its interpolation weights sum to at most 256, keeping numerators below 2^20. */
    for (unsigned d = 1U; d <= 256U; ++d)
    {
        for (int32_t q = 1025; q <= 1536; ++q)
        {
            int32_t value = q * (int32_t)d + (int32_t)d - 1;
            assert(divide_small(value, d) == value / (int32_t)d);
            assert(divide_small(-value, d) == -value / (int32_t)d);
        }
    }
    /* PIC and FLIP interpolation now reach 16384 and 32768 respectively. */
    const int32_t quotients[] = {1536, 4095, 4096, 16384, 32768};
    for (unsigned d = 1U; d <= 256U; ++d)
    {
        for (unsigned i = 0U; i < sizeof(quotients) / sizeof(quotients[0]); ++i)
        {
            int32_t value = quotients[i] * (int32_t)d + (int32_t)d - 1;
            assert(divide_small(value, d) == value / (int32_t)d);
            assert(divide_small(-value, d) == -value / (int32_t)d);
        }
    }
}

static void step(int16_t ax, int16_t ay)
{
    assert(fluid_sim_begin(&sim, ax, ay));
    unsigned slices = 0U;
    while (!fluid_sim_advance(&sim))
    {
        assert(++slices < 100U);
    }
    for (unsigned i = 0U; i < FLUID_PARTICLE_COUNT; ++i)
    {
        const fluid_particle_t *p = &sim.particles[i];
        assert(fluid_sim_contains(p->x, p->y));
        assert(abs(p->vx) <= 16384 && abs(p->vy) <= 16384);
    }
}

static int64_t center_x(void)
{
    int64_t total = 0;
    for (unsigned i = 0U; i < FLUID_PARTICLE_COUNT; ++i)
    {
        total += sim.particles[i].x;
    }
    return total;
}

static int64_t center_y(void)
{
    int64_t total = 0;
    for (unsigned i = 0U; i < FLUID_PARTICLE_COUNT; ++i)
    {
        total += sim.particles[i].y;
    }
    return total;
}

static int32_t divergence(void)
{
    int32_t total = 0;
    for (unsigned y = 0U; y < FLUID_GRID_SIZE; ++y)
    {
        for (unsigned x = 0U; x < FLUID_GRID_SIZE; ++x)
        {
            if (sim.scratch.cells.type[y * FLUID_GRID_SIZE + x] == FLUID_CELL_LIQUID)
            {
                unsigned i = y * FLUID_GRID_STRIDE + x;
                total += abs(sim.grid.velocity.current[i + 1U] - sim.grid.velocity.current[i] +
                             sim.grid.velocity.current[FLUID_FACE_COUNT + i + FLUID_GRID_STRIDE] -
                             sim.grid.velocity.current[FLUID_FACE_COUNT + i]);
            }
        }
    }
    return total;
}

static void test_ballistic_droplet(void)
{
    fluid_sim_init(&sim);
    sim.particles[0] = (fluid_particle_t){FLUID_CENTER, 3584, 240, -180};
    assert(fluid_sim_begin(&sim, 0, 0));
    while (sim.phase != FLUID_PHASE_TRANSFER)
    {
        assert(!fluid_sim_advance(&sim));
    }
    unsigned cell = (unsigned)(sim.particles[0].y / 1024) * FLUID_GRID_SIZE +
                    (unsigned)(sim.particles[0].x / 1024);
    assert(sim.scratch.cells.density[cell] <= 256U);
    while (!fluid_sim_advance(&sim))
    {
    }
    /* Grid pressure preserves a detached droplet's momentum after explicit drag. */
    assert(sim.particles[0].vx == 236 && sim.particles[0].vy == -177);
    assert(sim.particles[0].x == FLUID_CENTER + 472 && sim.particles[0].y == 3230);
    bool pixels[217];
    assert(fluid_sim_render(&sim, pixels));
    int32_t nearest_distance = INT32_MAX;
    unsigned nearest_led = 0U;
    for (unsigned led = 0U; led < 217U; ++led)
    {
        int16_t x, y;
        assert(fluid_sim_led_position(led, &x, &y));
        int32_t dx = x - sim.particles[0].x, dy = y - sim.particles[0].y;
        int32_t distance = dx * dx + dy * dy;
        if (distance < nearest_distance)
        {
            nearest_distance = distance;
            nearest_led = led;
        }
    }
    assert(pixels[nearest_led]);
}

static void test_splash_momentum(void)
{
    fluid_sim_init(&sim);
    /* Two nearby droplets share grid faces, which smooths their opposing velocities. */
    sim.particles[0] = (fluid_particle_t){FLUID_CENTER - 600, 3584, 200, 0};
    sim.particles[1] = (fluid_particle_t){FLUID_CENTER + 600, 3584, -200, 0};
    step(0, 0);
    assert(sim.particles[0].vx >= 150 && sim.particles[1].vx <= -150);
}

static void test_droplet_outline(void)
{
    fluid_sim_init(&sim);
    for (unsigned i = 1U; i < FLUID_PARTICLE_COUNT; ++i)
    {
        sim.particles[i] = (fluid_particle_t){FLUID_CENTER, 10500, 0, 0};
    }
    /* A droplet between two LEDs lights them without bridging to the next row. */
    sim.particles[0] = (fluid_particle_t){FLUID_CENTER + 352, FLUID_CENTER, 0, 0};
    bool pixels[217];
    assert(fluid_sim_render(&sim, pixels));
    assert(pixels[107] && pixels[108] && !pixels[124]);
}

int main(void)
{
    test_surface_tension();
    test_wall_rebound();
    test_velocity_damping();
    test_numeric_tables();
    test_high_speed_motion();
    test_high_speed_transfer();
    test_droplet_outline();
    test_splash_momentum();
    test_ballistic_droplet();
    test_step_duration();
    bool pixels[217];
    int16_t x, y;
    assert(sizeof(sim) <= 3072U);
    assert(fluid_sim_led_position(0U, &x, &y) && x > FLUID_CENTER && y > FLUID_CENTER);
    assert(fluid_sim_led_position(8U, &x, &y) && x < FLUID_CENTER && y > FLUID_CENTER);
    assert(fluid_sim_led_position(108U, &x, &y) && x == FLUID_CENTER && y == FLUID_CENTER);
    assert(fluid_sim_led_position(216U, &x, &y) && x < FLUID_CENTER && y < FLUID_CENTER);
    assert(!fluid_sim_led_position(217U, &x, &y));

    fluid_sim_init(&sim);
    for (unsigned i = 0U; i < FLUID_PARTICLE_COUNT; ++i)
    {
        assert(fluid_sim_contains(sim.particles[i].x, sim.particles[i].y));
        for (unsigned j = i + 1U; j < FLUID_PARTICLE_COUNT; ++j)
        {
            assert(sim.particles[i].x != sim.particles[j].x ||
                   sim.particles[i].y != sim.particles[j].y);
        }
    }
    assert(fluid_sim_render(&sim, pixels));
    unsigned lit = 0U;
    for (unsigned i = 0U; i < 217U; ++i)
    {
        lit += pixels[i] ? 1U : 0U;
    }
    assert(lit > 30U && lit < 160U);
    assert(fluid_sim_begin(&sim, 0, 0));
    assert(!fluid_sim_begin(&sim, 0, 0));
    assert(!fluid_sim_render(&sim, pixels));
    unsigned slices = 0U;
    while (!fluid_sim_advance(&sim))
    {
        assert(++slices < 100U);
    }
    assert(slices > 12U);
    fluid_sim_init(&sim);
    for (unsigned i = 0U; i < FLUID_PARTICLE_COUNT; ++i)
    {
        sim.particles[i].vx = (int16_t)((sim.particles[i].x - FLUID_CENTER) / 12);
        sim.particles[i].vy = (int16_t)((sim.particles[i].y - FLUID_CENTER) / 12);
    }
    assert(fluid_sim_begin(&sim, 0, 0));
    while (sim.phase != FLUID_PHASE_PROJECT)
    {
        assert(!fluid_sim_advance(&sim));
    }
    /* Isolate incompressibility from the separately applied density-drift target. */
    for (unsigned i = 0U; i < FLUID_GRID_SIZE * FLUID_GRID_SIZE; ++i)
    {
        sim.scratch.cells.density[i] = 0U;
    }
    int32_t before = divergence();
    assert(before > 0);
    while (sim.phase == FLUID_PHASE_PROJECT)
    {
        assert(!fluid_sim_advance(&sim));
    }
    assert(divergence() < before / 2);
    while (!fluid_sim_advance(&sim))
    {
    }

    fluid_sim_init(&sim);
    for (unsigned i = 0U; i < 120U; ++i)
    {
        step(-4096, 0);
    }
    int64_t right = center_x();
    fluid_sim_init(&sim);
    for (unsigned i = 0U; i < 120U; ++i)
    {
        step(4096, 0);
    }
    assert(right - center_x() > (int64_t)FLUID_PARTICLE_COUNT * 1024);
    fluid_sim_init(&sim);
    for (unsigned i = 0U; i < 120U; ++i)
    {
        step(0, -4096);
    }
    int64_t down = center_y();
    fluid_sim_init(&sim);
    for (unsigned i = 0U; i < 120U; ++i)
    {
        step(0, 4096);
    }
    assert(down - center_y() > (int64_t)FLUID_PARTICLE_COUNT * 1024);
    for (unsigned i = 0U; i < 600U; ++i)
    {
        static const int16_t gravity[][2] = {
            {-8192, 8191}, {8191, -8192}, {0, 4096}, {4096, 0}, {0, -4096}, {-4096, 0},
        };
        step(gravity[(i / 50U) % 6U][0], gravity[(i / 50U) % 6U][1]);
        assert(fluid_sim_render(&sim, pixels));
    }
    /* Run the complete pipeline with speeds at both limits, including rendering. */
    fluid_sim_init(&sim);
    for (unsigned i = 0U; i < FLUID_PARTICLE_COUNT; ++i)
    {
        sim.particles[i].vx = i % 2U ? 16384 : -16384;
        sim.particles[i].vy = i % 4U < 2U ? 16384 : -16384;
    }
    for (unsigned i = 0U; i < 100U; ++i)
    {
        step(i % 2U ? 8191 : -8192, i % 4U < 2U ? 8191 : -8192);
        assert(fluid_sim_render(&sim, pixels));
    }
    /* A packed cluster exercises separation and the largest transfer accumulators. */
    fluid_sim_init(&sim);
    for (unsigned i = 0U; i < FLUID_PARTICLE_COUNT; ++i)
    {
        sim.particles[i] = (fluid_particle_t){FLUID_CENTER, FLUID_CENTER, 0, 0};
    }
    for (unsigned i = 0U; i < 30U; ++i)
    {
        step(8191, -8192);
    }
    const unsigned reference_leds[] = {0U, 8U, 108U, 216U};
    for (unsigned k = 0U; k < sizeof(reference_leds) / sizeof(reference_leds[0]); ++k)
    {
        assert(fluid_sim_led_position(reference_leds[k], &x, &y));
        for (unsigned i = 0U; i < FLUID_PARTICLE_COUNT; ++i)
        {
            sim.particles[i] = (fluid_particle_t){x, y, 0, 0};
        }
        assert(fluid_sim_render(&sim, pixels));
        assert(pixels[reference_leds[k]]);
        unsigned lit_count = 0U;
        for (unsigned i = 0U; i < 217U; ++i)
        {
            if (pixels[i])
            {
                int16_t led_x, led_y;
                assert(fluid_sim_led_position(i, &led_x, &led_y));
                int32_t dx = led_x - x, dy = led_y - y;
                assert(dx * dx + dy * dy < 900 * 900);
                ++lit_count;
            }
        }
        assert(lit_count <= 7U);
    }
    printf("PIC/FLIP tests passed; state=%zu bytes, particles=%u, grid=%ux%u\n", sizeof(sim),
           FLUID_PARTICLE_COUNT, FLUID_GRID_SIZE, FLUID_GRID_SIZE);
    return 0;
}
