guolic1/LumaFlow/firmware/application/fluid_sim_tables.h

/* Derived from the fixed hexagon cell mask in fluid_sim.c: each open MAC face
 * stores its two adjacent cell indices; {0,0} denotes a blocked face.
 * reciprocal[d] = floor(2^20/d), for exact bounded division on Cortex-M0+. */
static const uint8_t face_cells[2U * FLUID_FACE_COUNT][2] = {
    {0, 0},     {0, 0},     {0, 0},     {0, 0},     {0, 0},     {0, 0},     {0, 0},     {0, 0},
    {0, 0},     {0, 0},     {0, 0},     {0, 0},     {0, 0},     {0, 0},     {0, 0},     {0, 0},
    {0, 0},     {0, 0},     {16, 17},   {17, 18},   {18, 19},   {19, 20},   {20, 21},   {21, 22},
    {0, 0},     {0, 0},     {0, 0},     {0, 0},     {0, 0},     {0, 0},     {0, 0},     {28, 29},
    {29, 30},   {30, 31},   {31, 32},   {32, 33},   {33, 34},   {34, 35},   {35, 36},   {0, 0},
    {0, 0},     {0, 0},     {0, 0},     {0, 0},     {0, 0},     {41, 42},   {42, 43},   {43, 44},
    {44, 45},   {45, 46},   {46, 47},   {47, 48},   {48, 49},   {0, 0},     {0, 0},     {0, 0},
    {0, 0},     {0, 0},     {53, 54},   {54, 55},   {55, 56},   {56, 57},   {57, 58},   {58, 59},
    {59, 60},   {60, 61},   {61, 62},   {62, 63},   {0, 0},     {0, 0},     {0, 0},     {0, 0},
    {66, 67},   {67, 68},   {68, 69},   {69, 70},   {70, 71},   {71, 72},   {72, 73},   {73, 74},
    {74, 75},   {75, 76},   {0, 0},     {0, 0},     {0, 0},     {0, 0},     {79, 80},   {80, 81},
    {81, 82},   {82, 83},   {83, 84},   {84, 85},   {85, 86},   {86, 87},   {87, 88},   {88, 89},
    {0, 0},     {0, 0},     {0, 0},     {0, 0},     {92, 93},   {93, 94},   {94, 95},   {95, 96},
    {96, 97},   {97, 98},   {98, 99},   {99, 100},  {100, 101}, {101, 102}, {0, 0},     {0, 0},
    {0, 0},     {0, 0},     {105, 106}, {106, 107}, {107, 108}, {108, 109}, {109, 110}, {110, 111},
    {111, 112}, {112, 113}, {113, 114}, {114, 115}, {0, 0},     {0, 0},     {0, 0},     {0, 0},
    {0, 0},     {119, 120}, {120, 121}, {121, 122}, {122, 123}, {123, 124}, {124, 125}, {125, 126},
    {126, 127}, {0, 0},     {0, 0},     {0, 0},     {0, 0},     {0, 0},     {0, 0},     {132, 133},
    {133, 134}, {134, 135}, {135, 136}, {136, 137}, {137, 138}, {138, 139}, {139, 140}, {0, 0},
    {0, 0},     {0, 0},     {0, 0},     {0, 0},     {0, 0},     {0, 0},     {146, 147}, {147, 148},
    {148, 149}, {149, 150}, {150, 151}, {151, 152}, {0, 0},     {0, 0},     {0, 0},     {0, 0},
    {0, 0},     {0, 0},     {0, 0},     {0, 0},     {0, 0},     {0, 0},     {0, 0},     {0, 0},
    {0, 0},     {0, 0},     {0, 0},     {0, 0},     {0, 0},     {0, 0},     {0, 0},     {0, 0},
    {0, 0},     {0, 0},     {0, 0},     {0, 0},     {0, 0},     {0, 0},     {0, 0},     {0, 0},
    {0, 0},     {0, 0},     {0, 0},     {0, 0},     {0, 0},     {0, 0},     {0, 0},     {0, 0},
    {0, 0},     {0, 0},     {0, 0},     {0, 0},     {0, 0},     {0, 0},     {0, 0},     {0, 0},
    {0, 0},     {0, 0},     {0, 0},     {0, 0},     {0, 0},     {0, 0},     {0, 0},     {0, 0},
    {0, 0},     {0, 0},     {0, 0},     {0, 0},     {0, 0},     {0, 0},     {0, 0},     {0, 0},
    {0, 0},     {0, 0},     {0, 0},     {16, 29},   {17, 30},   {18, 31},   {19, 32},   {20, 33},
    {21, 34},   {22, 35},   {0, 0},     {0, 0},     {0, 0},     {0, 0},     {0, 0},     {0, 0},
    {28, 41},   {29, 42},   {30, 43},   {31, 44},   {32, 45},   {33, 46},   {34, 47},   {35, 48},
    {36, 49},   {0, 0},     {0, 0},     {0, 0},     {0, 0},     {0, 0},     {41, 54},   {42, 55},
    {43, 56},   {44, 57},   {45, 58},   {46, 59},   {47, 60},   {48, 61},   {49, 62},   {0, 0},
    {0, 0},     {0, 0},     {0, 0},     {53, 66},   {54, 67},   {55, 68},   {56, 69},   {57, 70},
    {58, 71},   {59, 72},   {60, 73},   {61, 74},   {62, 75},   {63, 76},   {0, 0},     {0, 0},
    {0, 0},     {66, 79},   {67, 80},   {68, 81},   {69, 82},   {70, 83},   {71, 84},   {72, 85},
    {73, 86},   {74, 87},   {75, 88},   {76, 89},   {0, 0},     {0, 0},     {0, 0},     {79, 92},
    {80, 93},   {81, 94},   {82, 95},   {83, 96},   {84, 97},   {85, 98},   {86, 99},   {87, 100},
    {88, 101},  {89, 102},  {0, 0},     {0, 0},     {0, 0},     {92, 105},  {93, 106},  {94, 107},
    {95, 108},  {96, 109},  {97, 110},  {98, 111},  {99, 112},  {100, 113}, {101, 114}, {102, 115},
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
};

static const uint32_t reciprocal[705] = {
    0U,      1048576U, 524288U, 349525U, 262144U, 209715U, 174762U, 149796U, 131072U, 116508U,
    104857U, 95325U,   87381U,  80659U,  74898U,  69905U,  65536U,  61680U,  58254U,  55188U,
    52428U,  49932U,   47662U,  45590U,  43690U,  41943U,  40329U,  38836U,  37449U,  36157U,
    34952U,  33825U,   32768U,  31775U,  30840U,  29959U,  29127U,  28339U,  27594U,  26886U,
    26214U,  25575U,   24966U,  24385U,  23831U,  23301U,  22795U,  22310U,  21845U,  21399U,
    20971U,  20560U,   20164U,  19784U,  19418U,  19065U,  18724U,  18396U,  18078U,  17772U,
    17476U,  17189U,   16912U,  16644U,  16384U,  16131U,  15887U,  15650U,  15420U,  15196U,
    14979U,  14768U,   14563U,  14364U,  14169U,  13981U,  13797U,  13617U,  13443U,  13273U,
    13107U,  12945U,   12787U,  12633U,  12483U,  12336U,  12192U,  12052U,  11915U,  11781U,
    11650U,  11522U,   11397U,  11275U,  11155U,  11037U,  10922U,  10810U,  10699U,  10591U,
    10485U,  10381U,   10280U,  10180U,  10082U,  9986U,   9892U,   9799U,   9709U,   9619U,
    9532U,   9446U,    9362U,   9279U,   9198U,   9118U,   9039U,   8962U,   8886U,   8811U,
    8738U,   8665U,    8594U,   8525U,   8456U,   8388U,   8322U,   8256U,   8192U,   8128U,
    8065U,   8004U,    7943U,   7884U,   7825U,   7767U,   7710U,   7653U,   7598U,   7543U,
    7489U,   7436U,    7384U,   7332U,   7281U,   7231U,   7182U,   7133U,   7084U,   7037U,
    6990U,   6944U,    6898U,   6853U,   6808U,   6765U,   6721U,   6678U,   6636U,   6594U,
    6553U,   6512U,    6472U,   6432U,   6393U,   6355U,   6316U,   6278U,   6241U,   6204U,
    6168U,   6132U,    6096U,   6061U,   6026U,   5991U,   5957U,   5924U,   5890U,   5857U,
    5825U,   5793U,    5761U,   5729U,   5698U,   5667U,   5637U,   5607U,   5577U,   5548U,
    5518U,   5489U,    5461U,   5433U,   5405U,   5377U,   5349U,   5322U,   5295U,   5269U,
    5242U,   5216U,    5190U,   5165U,   5140U,   5115U,   5090U,   5065U,   5041U,   5017U,
    4993U,   4969U,    4946U,   4922U,   4899U,   4877U,   4854U,   4832U,   4809U,   4788U,
    4766U,   4744U,    4723U,   4702U,   4681U,   4660U,   4639U,   4619U,   4599U,   4578U,
    4559U,   4539U,    4519U,   4500U,   4481U,   4462U,   4443U,   4424U,   4405U,   4387U,
    4369U,   4350U,    4332U,   4315U,   4297U,   4279U,   4262U,   4245U,   4228U,   4211U,
    4194U,   4177U,    4161U,   4144U,   4128U,   4112U,   4096U,   4080U,   4064U,   4048U,
    4032U,   4017U,    4002U,   3986U,   3971U,   3956U,   3942U,   3927U,   3912U,   3898U,
    3883U,   3869U,    3855U,   3840U,   3826U,   3813U,   3799U,   3785U,   3771U,   3758U,
    3744U,   3731U,    3718U,   3705U,   3692U,   3679U,   3666U,   3653U,   3640U,   3628U,
    3615U,   3603U,    3591U,   3578U,   3566U,   3554U,   3542U,   3530U,   3518U,   3506U,
    3495U,   3483U,    3472U,   3460U,   3449U,   3437U,   3426U,   3415U,   3404U,   3393U,
    3382U,   3371U,    3360U,   3350U,   3339U,   3328U,   3318U,   3307U,   3297U,   3287U,
    3276U,   3266U,    3256U,   3246U,   3236U,   3226U,   3216U,   3206U,   3196U,   3187U,
    3177U,   3167U,    3158U,   3148U,   3139U,   3130U,   3120U,   3111U,   3102U,   3093U,
    3084U,   3075U,    3066U,   3057U,   3048U,   3039U,   3030U,   3021U,   3013U,   3004U,
    2995U,   2987U,    2978U,   2970U,   2962U,   2953U,   2945U,   2937U,   2928U,   2920U,
    2912U,   2904U,    2896U,   2888U,   2880U,   2872U,   2864U,   2857U,   2849U,   2841U,
    2833U,   2826U,    2818U,   2811U,   2803U,   2796U,   2788U,   2781U,   2774U,   2766U,
    2759U,   2752U,    2744U,   2737U,   2730U,   2723U,   2716U,   2709U,   2702U,   2695U,
    2688U,   2681U,    2674U,   2668U,   2661U,   2654U,   2647U,   2641U,   2634U,   2628U,
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
};

/* Divisors are in 1..704. Small inputs use a uint32 reciprocal product whose
 * estimate is at most one too small. Larger velocity sums require full division. */
static inline int32_t divide_small(int32_t value, unsigned divisor)
{
    uint32_t magnitude = value < 0 ? 0U - (uint32_t)value : (uint32_t)value;
    if (magnitude >= (1U << 20U) || magnitude / 4096U >= divisor)
    {
        return value / (int32_t)divisor;
    }
    uint32_t quotient = (magnitude * reciprocal[divisor]) >> 20U;
    quotient += magnitude - quotient * divisor >= divisor;
    return value < 0 ? -(int32_t)quotient : (int32_t)quotient;
}
