guolic1/LumaFlow/firmware/application/led_matrix_scan.c

#include "led_matrix_scan.h"

#include <stddef.h>
#include <string.h>

#define LED_MATRIX_NO_LED UINT8_MAX

typedef struct
{
    uint8_t anode;
    uint8_t cathode;
} led_connection_t;

typedef struct
{
    uint8_t first;
    uint8_t second;
} led_slot_t;

/* Extracted from circuit/LED_Matrix.kicad_sch through KiCad's netlist export.
 * Each slot is an induced directed matching: no GPIO shares two LED loads,
 * and no additional LED directly connects an enabled source to a sink.
 * Wiring changes require revalidating both tables against the schematic. */
static const led_connection_t connections[LED_MATRIX_LED_COUNT] = {
    {1U, 0U},   /* D1 */
    {2U, 0U},   /* D2 */
    {3U, 0U},   /* D3 */
    {4U, 0U},   /* D4 */
    {5U, 0U},   /* D5 */
    {6U, 0U},   /* D6 */
    {7U, 0U},   /* D7 */
    {8U, 0U},   /* D8 */
    {9U, 0U},   /* D9 */
    {0U, 1U},   /* D10 */
    {2U, 1U},   /* D11 */
    {3U, 1U},   /* D12 */
    {4U, 1U},   /* D13 */
    {5U, 1U},   /* D14 */
    {6U, 1U},   /* D15 */
    {7U, 1U},   /* D16 */
    {8U, 1U},   /* D17 */
    {9U, 1U},   /* D18 */
    {10U, 1U},  /* D19 */
    {0U, 2U},   /* D20 */
    {1U, 2U},   /* D21 */
    {3U, 2U},   /* D22 */
    {4U, 2U},   /* D23 */
    {5U, 2U},   /* D24 */
    {6U, 2U},   /* D25 */
    {7U, 2U},   /* D26 */
    {8U, 2U},   /* D27 */
    {9U, 2U},   /* D28 */
    {10U, 2U},  /* D29 */
    {11U, 2U},  /* D30 */
    {0U, 3U},   /* D31 */
    {1U, 3U},   /* D32 */
    {2U, 3U},   /* D33 */
    {4U, 3U},   /* D34 */
    {5U, 3U},   /* D35 */
    {6U, 3U},   /* D36 */
    {7U, 3U},   /* D37 */
    {8U, 3U},   /* D38 */
    {9U, 3U},   /* D39 */
    {10U, 3U},  /* D40 */
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
};

static const led_slot_t slots[LED_MATRIX_SLOT_COUNT] = {
    {9U, 126U},                /* D10, D127 */
    {19U, 127U},               /* D20, D128 */
    {30U, 128U},               /* D31, D129 */
    {42U, 129U},               /* D43, D130 */
    {55U, 130U},               /* D56, D131 */
    {69U, 131U},               /* D70, D132 */
    {84U, 132U},               /* D85, D133 */
    {0U, 141U},                /* D1, D142 */
    {20U, 142U},               /* D21, D143 */
    {31U, 143U},               /* D32, D144 */
    {43U, 144U},               /* D44, D145 */
    {56U, 145U},               /* D57, D146 */
    {70U, 146U},               /* D71, D147 */
    {85U, 147U},               /* D86, D148 */
    {1U, 155U},                /* D2, D156 */
    {10U, 156U},               /* D11, D157 */
    {32U, 157U},               /* D33, D158 */
    {44U, 158U},               /* D45, D159 */
    {57U, 159U},               /* D58, D160 */
    {71U, 160U},               /* D72, D161 */
    {86U, 161U},               /* D87, D162 */
    {2U, 168U},                /* D3, D169 */
    {11U, 169U},               /* D12, D170 */
    {21U, 170U},               /* D22, D171 */
    {45U, 171U},               /* D46, D172 */
    {58U, 172U},               /* D59, D173 */
    {72U, 173U},               /* D73, D174 */
    {87U, 174U},               /* D88, D175 */
    {3U, 180U},                /* D4, D181 */
    {12U, 181U},               /* D13, D182 */
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
    {167U, LED_MATRIX_NO_LED}, /* D168 */
    {175U, LED_MATRIX_NO_LED}, /* D176 */
    {176U, LED_MATRIX_NO_LED}, /* D177 */
    {177U, LED_MATRIX_NO_LED}, /* D178 */
    {178U, LED_MATRIX_NO_LED}, /* D179 */
    {179U, LED_MATRIX_NO_LED}, /* D180 */
    {187U, LED_MATRIX_NO_LED}, /* D188 */
    {188U, LED_MATRIX_NO_LED}, /* D189 */
    {189U, LED_MATRIX_NO_LED}, /* D190 */
    {190U, LED_MATRIX_NO_LED}, /* D191 */
    {198U, LED_MATRIX_NO_LED}, /* D199 */
    {199U, LED_MATRIX_NO_LED}, /* D200 */
    {200U, LED_MATRIX_NO_LED}, /* D201 */
    {208U, LED_MATRIX_NO_LED}, /* D209 */
    {209U, LED_MATRIX_NO_LED}, /* D210 */
};

void led_matrix_scan_init(led_matrix_scan_t *scan)
{
    memset(scan->frames, 0, sizeof(scan->frames));
    scan->slot = 0U;
    scan->active_frame = 0U;
    atomic_init(&scan->pending, false);
}

bool led_matrix_scan_submit(led_matrix_scan_t *scan, const bool pixels[LED_MATRIX_LED_COUNT])
{
    if (pixels == NULL || atomic_load_explicit(&scan->pending, memory_order_acquire))
    {
        return false;
    }

    memcpy(scan->frames[scan->active_frame ^ 1U], pixels, sizeof(scan->frames[0]));
    /* Publish only after the complete back buffer is available to the ISR. */
    atomic_store_explicit(&scan->pending, true, memory_order_release);
    return true;
}

led_matrix_drive_t led_matrix_scan_next(led_matrix_scan_t *scan)
{
    led_matrix_drive_t drive = {0U, 0U};

    if (scan->slot == 0U && atomic_load_explicit(&scan->pending, memory_order_acquire))
    {
        scan->active_frame ^= 1U;
        atomic_store_explicit(&scan->pending, false, memory_order_release);
    }

    const led_slot_t *slot = &slots[scan->slot];
    const uint8_t indices[2] = {slot->first, slot->second};
    for (unsigned int item = 0U; item < 2U; ++item)
    {
        uint8_t index = indices[item];
        if (index != LED_MATRIX_NO_LED && scan->frames[scan->active_frame][index])
        {
            drive.high |= 1UL << connections[index].anode;
            drive.low |= 1UL << connections[index].cathode;
        }
    }

    if (++scan->slot == LED_MATRIX_SLOT_COUNT)
    {
        scan->slot = 0U;
    }
    /* IO17/PB8 is an anode only (D117, D133..D217 along the upper-left edge).
     * Discharge it when unused; no LED cathode connects to this extra sink. */
    if ((drive.high & (1UL << 17U)) == 0U)
    {
        drive.low |= 1UL << 17U;
    }
    return drive;
}
