guolic1/LumaFlow/(commit log)

2026-09-23 Init commit
    [LED_Matrix.kicad_sch, LumaFlow.kicad_pcb, LumaFlow.kicad_sch]
2026-09-27 feat(hardware): update circuit to small size
    [IMU.kicad_sch, LED_Matrix.kicad_sch, LumaFlow.kicad_pcb, LumaFlow.kicad_sch, MCU.kicad_sch, Power.kicad_sch]
2026-09-27 feat(hardware): add kicad lib table
2026-09-30 chore(hardware): add .gitignore in circuit
2026-09-30 feat(hardware): complete hardware
    [IMU.kicad_sch, LED_Matrix.kicad_sch, LumaFlow.kicad_pcb, LumaFlow.kicad_sch, LumaFlowShell.FCStd, MCU.kicad_sch, Power.kicad_sch]
2026-09-30 build(vscode): 配置固件编译下载与调试任务
    通过独立本地路径配置连接 CMake、Ninja、Arm 工具链和 OpenOCD。使用项目路径键显式传入 Cortex-Debug，避免窗口级设置在文件夹配置中被忽略；未设置探针配置时阻止下载和调试。
2026-09-30 feat(vscode): 添加固件操作按钮与使用说明
2026-09-30 feat(firmware):添加cubemx初始化工程
2026-10-01 chore: 更新.gitignore
2026-10-01 feat(shell): 更新外壳文件
    [LumaFlowShell.FCStd]
2026-10-01 refactor(firmware): 将 CubeMX 工程集中到 board 目录
2026-10-01 refactor(firmware): 将应用入口分离到 application 目录
2026-10-01 build(firmware): 独立应用链接脚本并忽略生成工程配置
2026-10-01 build(vscode): 将工作区配置和忽略规则迁入 firmware
2026-10-01 refactor(board): 将 GPIO 和时钟初始化切换为 LL
2026-10-01 build(firmware): 将应用堆预留容量设为零
2026-10-01 docs(firmware): 说明目录结构和 VS Code 开发方式
2026-10-01 feat(bootloader): 增加独立入口和链接脚本
    通过 LUMAFLOW_IMAGE 选择镜像，各自使用 main.c 和链接脚本。暂不划分 Flash，两份镜像仍从 0x08000000 开始，仅可分别下载运行。
2026-10-01 build(firmware): 分离镜像配置与编译模式
    使用 Ninja Multi-Config，在 VS Code 中分别选择 Application/Bootloader 和 Debug/Release。编译、下载、调试及代码补全跟随当前选择，本地工具路径继续集中于 settings.json。
2026-10-01 perf(firmware): 为 Release 开启 LTO 跨文件优化
2026-10-01 perf(firmware): 将 Debug 优化级别切换为 Og
2026-10-01 feat(firmware): 修改工程为使用LL库
2026-10-01 build(firmware): 为 VS Code 配置两种镜像的编译数据库
2026-10-01 build(firmware): 配置四空格格式化并排除 board
2026-10-01 refactor(firmware): 统一入口缩进并清理多余空行
2026-10-01 feat(firmware): 划分8KB引导区并配置双镜像向量表
2026-10-01 feat(firmware):bootloader增加UART初始化设置
2026-10-01 feat(firmware):添加共享串口命令框架
2026-10-01 feat(firmware):添加UART中断和DMA初始化代码
2026-10-01 feat(firmware):修改DMA和串口生成配置
2026-10-01 feat(firmware):使用DMA实现串口收发
2026-10-01 feat(bootloader):实现应用原子升级
2026-10-01 feat(protocol):增加应用升级命令
2026-10-01 test(bootloader):增加应用镜像校验测试
2026-10-01 docs(bootloader):说明应用升级流程
2026-10-08 feat(bootloader): 将非 SWD 矩阵引脚初始化为输入下拉
2026-10-08 fix(bootloader): 将全部 LED 矩阵引脚改为内部上拉
2026-10-08 fix(bootloader): 将全部 LED 矩阵引脚改为内部下拉
2026-10-08 Revert "fix(bootloader): 将全部 LED 矩阵引脚改为内部下拉"
    This reverts commit 9d908c328ee57343d2c7287ff7af43023cc014be.
2026-10-08 fix(bootloader): 关闭全部 LED 矩阵引脚的内部上下拉
2026-10-09 feat(bootloader): 将应用启动等待窗口延长至 3 秒
2026-10-09 feat(firmware): 在应用接管时保留矩阵开漏释放状态
2026-10-09 feat(firmware):修改cubemx串口波特率配置到1M
2026-10-09 feat(bootloader): 使用 HSI16 时钟运行 1 Mbps 串口
2026-10-09 feat(scripts): 增加固件串口通信工具
2026-10-09 feat(scripts): 增加 Application 串口 OTA 升级
2026-10-09 fix(scripts): 同步固件默认串口波特率为 1 Mbps
2026-10-09 feat(scripts): 增加命令行帮助参数
2026-10-10 feat(scripts): 等待串口出现并重试打开
2026-10-10 feat(scripts): 增加命令重试与 5 秒响应超时
    PING、设备信息和升级状态查询在静默时每 100 ms 重发，所有尝试共用单次命令超时。
    复位与启动在重发之间查询当前镜像，收到确认后等待目标镜像响应，避免反复复位。
    擦写命令仅等待一次响应，防止缺少去重支持的固件重复处理已执行的请求。
    验证：在 powershell 和 pwsh 下运行 firmware/scripts/tests/cli_test.ps1、
    connection_test.ps1 和 ota_test.ps1，全部通过；ota_test.ps1 包含协议及重试测试。
2026-10-10 feat(application): 增加串口控制的单灯 PWM 测试
2026-10-10 feat(scripts): 增加单灯 PWM 占空比设置命令
2026-10-10 build(firmware): 构建后自动生成 HEX 和 BIN
2026-10-10 Revert "feat(scripts): 增加单灯 PWM 占空比设置命令"
    This reverts commit 4f825e40db542ca2a4d9bd37fc08ad1e5acfb697.
2026-10-10 Revert "feat(application): 增加串口控制的单灯 PWM 测试"
    This reverts commit 8e10eb25fbcaafea0ed3b0e2c5c3d27e16946b55.
2026-10-10 feat(scripts): 增加构建并烧录 Application 的 OTA 入口
2026-10-10 feat(application): 添加 LED 矩阵的 161 时隙扫描核心
2026-10-10 feat(application): 接入 TIM14 的 100Hz LED 矩阵驱动
    有效 LED 端使用推挽输出，未使用引脚保持输入高阻；切换时先消隐，再启用低电平端和高电平端。启动前检查时钟与 PF2 的 NRST_MODE，默认全灭，进入 Bootloader 的复位流程前停止扫描。Application Debug 和 Release 构建均通过，硬件电流、误亮与时序仍需板上验证。
2026-10-11 feat(application): 增加 QMA6100P 的 100Hz 定时采集
2026-10-11 feat(protocol): 增加 IMU 数据与状态查询指令
2026-10-11 feat(scripts): 增加 IMU 持续读取与 CSV 输出
2026-10-11 fix(application): 补全 QMA6100P 模拟前端启动序列
    依据 QST Rev. E 第 6.3 节，在量程配置前检查 OTP 和芯片状态并执行模拟前端初始化。为轮询和复位设置上限，失败时保留未就绪状态。新增启动顺序、等待、重试耗尽及总线失败测试。
    验证：WSL CTest 5/5 通过；Application-Debug 和 Application-Release 构建通过；clang-format --dry-run --Werror 与 git diff --check 通过。尚未重新烧录实板验证满量程固定输出是否消失。
2026-10-11 feat(application): 添加定点 PIC/FLIP 液体模拟核心
2026-10-11 feat(application): 接入 IMU 液体效果与性能查询
2026-10-11 fix(application): 拉低未使用的 IO17 以减少边缘误亮
2026-10-11 perf(application): 减少液体计算中的软件除法开销
2026-10-11 perf(application): 降低液体粒子规模并保持填充面积
2026-10-11 docs(firmware): 记录 IO16 上拉导致边缘误亮的路径
2026-10-11 chore(docs): 取消跟踪并忽略设计与计划文档
2026-10-11 docs(firmware): 精简 README 为开发与使用说明
2026-10-11 perf(application): 简化 LED 中断的 GPIO 映射以降低扫描开销
2026-10-11 fix(scripts): 兼容 30Hz 流体性能查询
2026-10-11 feat(application): 将流体模拟改为 30Hz 并同步积分步长
2026-10-11 fix(scripts): 支持 25Hz 流体性能查询
2026-10-11 feat(application): 将 LED 矩阵刷新率提高到约 120Hz
2026-10-11 feat(application): 将流体模拟改为 25Hz 并按四个 IMU 周期调度
2026-10-11 fix(application): 按 IMU 样本累计摇晃输入以减少响应延迟
2026-10-11 feat(application): 增强流体加速度响应与飞溅惯性
2026-10-11 feat(application): 收紧水滴轮廓以显示分离的飞溅
2026-10-11 fix(application): 修复大速度插值时定点除法溢出
2026-10-11 feat(application): 将流体速度上限提高到 16384 并处理高速碰撞
2026-10-11 refactor(application): 将液体效果参数集中为宏配置
2026-10-11 feat(application): 增加每步可调的流体速度阻尼
2026-10-11 feat(application): 增加可调的六边形墙面反弹
2026-10-11 feat(application): 增加短距离粒子凝聚以近似表面张力
2026-10-11 fix(application): 保持宏参数调节下的有符号流体运算
2026-10-14 feat(application): 修改流体仿真配置
2026-10-14 test(application): 固定流体回归用例的校准参数
2026-10-14 feat(application): 支持保留液体状态的暂停与恢复
2026-10-14 feat(application): 静止 30 秒后休眠并在运动时恢复
2026-10-14 feat(application): 将休眠与唤醒阈值调整为 0.1g 和 0.5g
2026-10-14 feat(scripts): 按设备量程换算 IMU 数据并支持 ±8g
2026-10-14 feat(application): 将 IMU 改为 ±8g 并同步流体与休眠换算
2026-10-14 feat(application): 将休眠和唤醒阈值调整为 0.5g 与 2g
2026-10-14 feat(application): 支持 QMA6100P 低速运动中断检测
2026-10-14 feat(application): 使用 IMU 运动中断从 Stop1 唤醒
    保持 0.5g 持续 30 秒的静止判定，休眠时关闭 UART 和周期采集，由 25Hz IMU 相邻样本变化 2g 的锁存中断唤醒。恢复 64MHz 时钟与 100Hz 采集，并用 RTC/LSI 补偿休眠时间戳。
    验证：ProtocolTests 和 ASan/UBSan 各 11 项通过，Application Release/Debug 构建及 clang-format 检查通过。实板休眠电流、ODR 和唤醒尚未验证。
2026-10-15 fix(application): 等待 IMU 数据更新后接通休眠唤醒中断
    切换 ODR 时先屏蔽中断输出并保持检测器复位，等待连续两组 XYZ 新数据后清除初始化状态，最后映射 INT1 和使能 EXTI。恢复 100Hz 也确认数据更新，避免把切换期间的旧值继续发布。等待约 1 秒仍无更新则返回配置错误。
    ProtocolTests 与 ASan/UBSan 各 11 项通过；Application Release/Debug 构建通过。增加了 600ms 无新数据、初始检测事件、配置边沿和真实事件保留的模拟回归测试，实板效果待复测。
2026-10-15 fix(application): 在开启 IMU 唤醒检测前关闭显示和串口
    将 LED 和串口关闭产生的负载切换放到 IMU 数据更新等待及中断清除之前，保持现有运动阈值和配置失败处理。增加负载切换瞬态的模拟回归验证。
    验证：WSL ProtocolTests 的 ctest 全部 11 项通过；Application-Release 构建、clang-format --dry-run --Werror 和 git diff --check 通过。尚未验证实板误唤醒是否消失。
2026-10-15 feat(application): 增加 IMU 休眠唤醒原因诊断
    保留运动状态、空中断及读取失败的计数，并在恢复采样率前记录加速度观测值。通过只读 GET_WAKE 和串口 wake 指令查询，保持原有唤醒判定和错误恢复行为。诊断加速度读取失败单独报告，不改变唤醒决定。
    验证：ProtocolTests 的 ctest 全部 11 项通过；PowerShell imu、fluid、wake、cli 测试通过；Application-Release 构建、clang-format 和 git diff --check 通过。实板误唤醒原因仍需诊断输出确认。
2026-10-15 fix(application): 通过主时钟降低 IMU 休眠采样率
    保持 BW 采样分频为已验证的运行设置，通过 MCLK 选择休眠目标采样率，恢复运行时还原 51.2kHz 主时钟。保留 CIC 复位时序位、运动阈值、锁存和错误处理。
    验证：ProtocolTests 的 ctest 全部 11 项通过；Application-Release 构建、诊断镜像校验、clang-format 和 git diff --check 通过。已生成 5 秒休眠候选固件；新的主时钟降采样方式及实板唤醒稳定性仍需确认。
